dlandry8/shakey/README.md

# shakey
Shakey, the self-balancing robot

The final report for this project is included here.
