dlandry8/shakey/Shaky, the Incredible Self-Balancing Robot.pptx

## Shaky, the Incredible Self-Balancing Robot

Jerahmy Bindon, Enbain Kuang, David Landry, Surafel Mamo

## Shaky

Accelerometer Sensor

AdaFruit Motor Shield v2

Stepper Motor

9.4 V Battery

Stepper Motor

## Slide 3

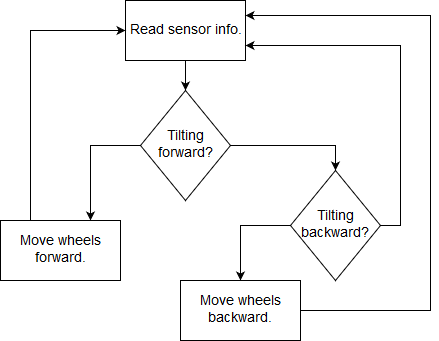
[picture p1: figure]
